Commerry/FERTILIZER_NOx/GUITION ESP32-4848S040/Copilot_20260508_205834.png

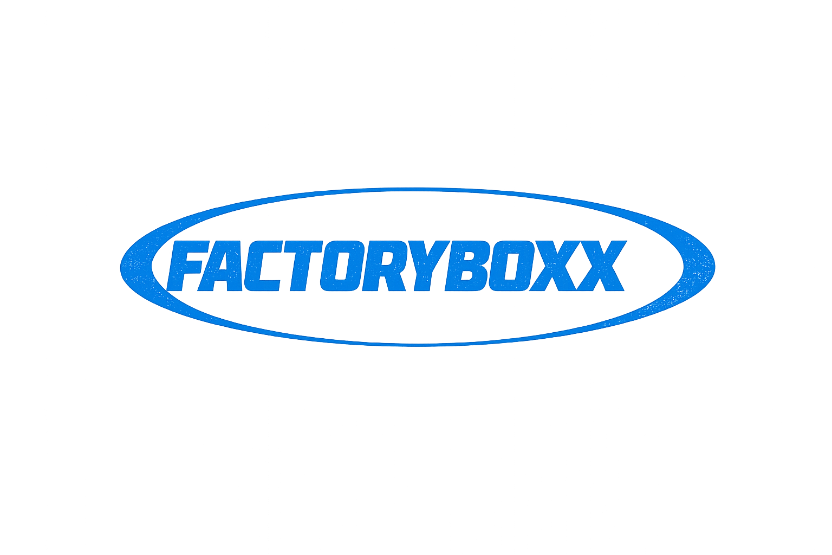
GUITION ESP32-4848S040/Copilot_20260508_205834.png
