Commerry/FERTILIZER_NOx/GUITION ESP32-4848S040/soil.png

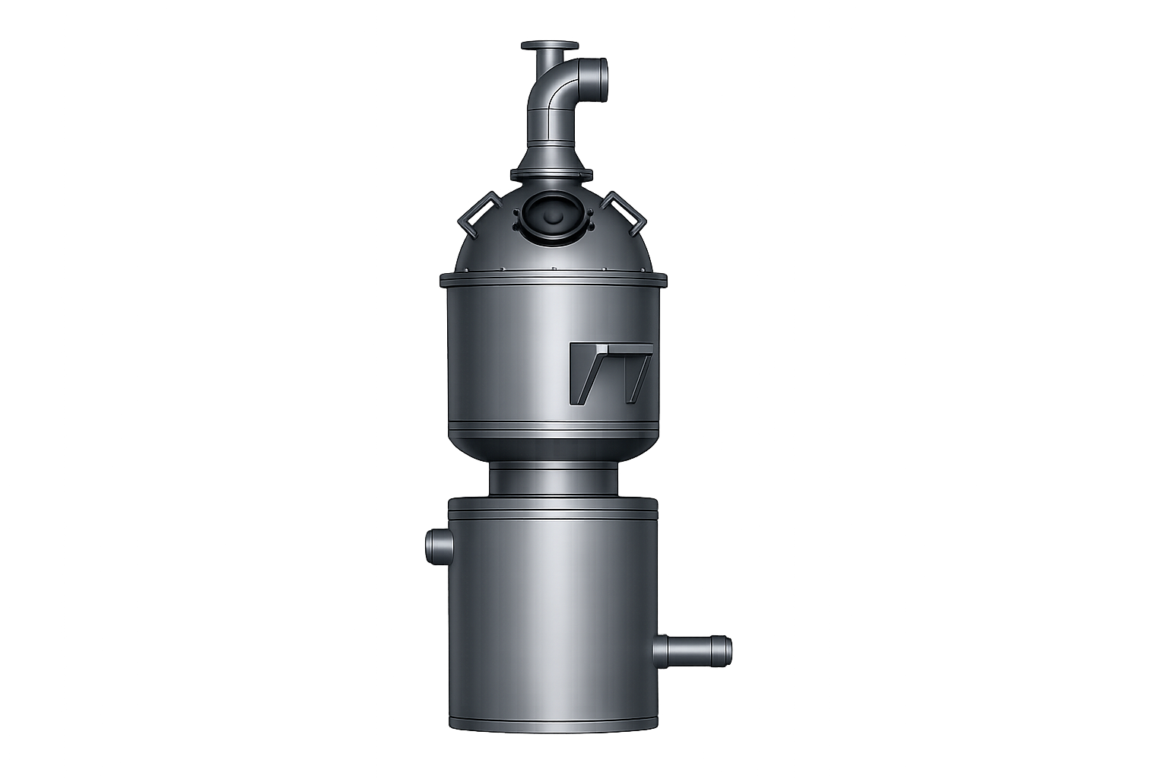
GUITION ESP32-4848S040/soil.png
