Commerry/FERTILIZER_NOx/config.h

// ============================================================================
//  config.h  --  Arduino Nano (ATmega328P)  pin map + ค่าคงที่ของระบบ
//
//  *** แก้ pin / ชื่ออุปกรณ์ ที่ไฟล์นี้ที่เดียว ***
// ============================================================================
#ifndef CONFIG_H
#define CONFIG_H

#include <Arduino.h>

// ===========================================================================
//                            แผนผังขา (ของจริงที่ต่ออยู่)
//
//   D0  RX0   <-- ESP32 GPIO43 (TX)   ลิงก์จอ (HW UART)  ** ถอดจอก่อนอัปโหลด! ข้อ 5 **
//   D1  TX0   --> ESP32 GPIO44 (RX)   ลิงก์จอ            ** ต้องมี divider -- ข้อ 6 **
//   D2        <-- MAX485 RO (2 โมดูลพ่วงกัน)   RS485 (SoftwareSerial RX)
//   D3        --> MAX485 DI (2 โมดูลพ่วงกัน)   RS485 (SoftwareSerial TX)
//   D4        --> Relay วาล์ว RV เปิด (OPEN)
//   D5        --> Relay วาล์ว RV ปิด  (CLOSE)
//   D6        --> MAX485 #2  DE+RE พ่วงกัน   = บัส pressure (id3)  ** ดูข้อ 2 **
//   D7        --> MAX485 #1  DE+RE พ่วงกัน   = บัส O2 (ตามสายที่บัดกรีจริง)
//   D8        --> MAX3485 EN      = บัส O2-B (ดักเฟรม FF)
//   D9        --> CB blower -- ต่อ VSP(สายขาว) ตรง ๆ จ่าย 5V run/stop (ไม่ใช้รีเลย์)
//   D10       --> Relay CP (ปั๊มหมุนเวียน)
//   D11       --> พายลอตแลมป์ เขียว (เดินเครื่อง)
//   D12       --> พายลอตแลมป์ แดง (หยุด/alarm/estop) -- ย้ายจาก D10
//   D13       ว่าง (เดิม Relay FP -- ย้ายไป A5 เพราะ D13 ขับรีเลย์ไม่แรงพอ/LED บูต)
//   A0        <-- ปุ่มรีเซ็ต (กด 5วิ=reset alarm, 10วิ=reset บอร์ด)
//   A1        <-- ปุ่มสำรอง (ยังไม่ใช้)
//   A2        <-- feedback วาล์ว เทา (เปิดสุด)  INPUT_PULLUP
//   A3        <-- feedback วาล์ว ดำ  (ปิดสุด)  INPUT_PULLUP
//   A4        --> Relay FB (โบลเวอร์ป้อน)
//   A5        --> Relay FP (ปั๊มป้อน)
//   A6, A7    *** ใช้เป็น output ไม่ได้เลย *** (ดูข้อ 7)
// ===========================================================================
//
//  เหตุผลที่บังคับ pin map นี้ -- อ่านก่อนย้ายขา!
//
//  1) *** ทำไมจอได้ HW UART (D0/D1) และ RS485 ไป SoftwareSerial (D2/D3) ***
//     ผู้ใช้เลือกเอง (บัดกรี RS485 ตายตัว แต่จอเป็นปลั๊กถอดได้):
//       - ตอนอัปโหลดเฟิร์มแวร์ ต้องถอดสายจอ (D0/D1 ชนกับ USB) -- ถอดง่าย มีปลั๊ก
//       - RS485 บน D2/D3 = ผังเดียวกับที่ทดสอบบนโต๊ะจนพิสูจน์แล้วว่าอ่านได้จริง
//     ข้อแลก: ระหว่าง SoftwareSerial คุย Modbus (ปิด interrupt ~1ms/byte @9600)
//     เฟรมจากจอที่เข้ามาพอดีอาจตกหล่น -> ไม่เป็นไร ลิงก์จอมี CRC + ACK + retry
//     (ออกแบบมาให้ทนหลุดตั้งแต่แรก)  ส่วน Modbus ได้ช่องสัญญาณเงียบ ๆ ของตัวเอง
//
//  2) *** RS485 มี "2 บัสแยกกัน" -- ห้ามยุบรวม! ***
//     pressure transmitter (24V) นิสัยผิดสเปค: หลังตอบครั้งแรกมันขับบัสค้าง
//     (driver hold ~3V) ตลอดเวลา -> ไดรเวอร์ตัวเล็กของ O2 สู้ไม่ได้ = O2 ใบ้สนิท
//     พิสูจน์แล้วด้วยมิเตอร์ + ไล่ทฤษฎีครบ (ขั้ว/กราวด์/bias/id ชน -- ตกหมด)
//     ทางเดียวที่จบ: ขังเดี่ยว pressure ไว้บัสของมันเอง
//       บัส O2 (D6)      : O2#1 id1 + O2#2 id2   (รุ่นเดียวกัน อยู่ร่วมกันได้)
//       บัส pressure (D7): pressure id3 ตัวเดียว
//     RO/DI ใช้สายร่วมกันได้ เพราะเลือกเปิดทีละโมดูล
//
//  3) *** กติกา DE+RE พ่วงขาเดียว/โมดูล (complement rule) ***
//     ขา LOW = โมดูล "เปิดหู" -> RO ขับสาย D2
//     ถ้า D6 กับ D7 LOW พร้อมกัน -> RO สองตัวขับสายเดียวกัน = ชนกัน!
//     กติกาใน modbus_sensors.cpp: ขาที่ไม่ได้ใช้งานต้องค้าง HIGH เสมอ
//     (โมดูลที่ HIGH = หูปิด + ขับบัสตัวเองนิ่งที่ idle = ดีต่อสัญญาณด้วย)
//
//  4) *** D13 (Relay 4 = ปั๊ม FP) มีข้อแลกเปลี่ยนที่ต้องรู้ ***
//     D13 มี LED บนบอร์ดต่ออยู่ และ bootloader กะพริบ LED นี้ทุกครั้งที่รีเซ็ต
//     -> ปั๊ม FP จะกระตุกสั้น ๆ ทุกครั้งที่เปิดเครื่อง / กดรีเซ็ต / อัปโหลดโปรแกรม
//     แก้ในซอฟต์แวร์ไม่ได้ เพราะมันเกิดก่อนโค้ดเราจะได้รัน  (ยอมรับข้อนี้แล้ว)
//
//     สิ่งที่ทำได้แล้ว: ลบไฟ heartbeat ที่เคยกะพริบ D13 ทุก 500 ms ทิ้ง
//     (ถ้าปล่อยไว้ ปั๊มจะคลิกวินาทีละ 2 ครั้ง "ตลอดเวลา" ไม่ใช่แค่ตอนบูต)
//     และ act_begin() ตั้งระดับไฟ "ดับ" ก่อนเปลี่ยนขาเป็น OUTPUT
//     -> ตอนโค้ดเราเริ่มทำงาน ไม่มีคลิกเพิ่มอีก
//
//     ถ้าวันหลังทนไม่ไหว: ย้ายไป D4/D5/D8 (ว่างอยู่) แก้ PIN_RELAY_FP บรรทัดเดียว
//     หรือคา RC low-pass (100k + 10uF) คั่นขา D13 -> รีเลย์ กรองพัลส์สั้นทิ้ง
//     (รอบปั๊มเป็นนาที ๆ อยู่แล้ว หน่วงไม่กี่ร้อย ms ไม่กระทบอะไร)
//
//  5) *** D0/D1 เป็นขาเดียวกับชิพ USB -- ถอดปลั๊กจอก่อนอัปโหลดทุกครั้ง! ***
//     ESP32 ส่งข้อความหา Nano ตลอดเวลา (คำสั่ง + retry) ถ้าเสียบคาไว้ตอนอัปโหลด
//     มันจะพ่นใส่ D0 พร้อมชิพ USB -> "not in sync" อัปไม่ผ่าน
//     จอทำเป็นปลั๊กถอดได้ตามดีไซน์นี้อยู่แล้ว: ถอด -> อัป -> เสียบกลับ
//     และห้ามมี Serial.print() debug ที่ไหนเลย -- Serial คือสายจอแล้ว
//     ขยะจะตกเฟรม/ตก CRC ฝั่งจอ (ลิงก์ไม่พังแต่เปลืองรอบ retry)
//
//  6) *** D1 (TX ของ Nano) เป็น 5V แต่ขา RX ของ ESP32 ทน 3.3V เท่านั้น ***
//     ต้องผ่าน divider 1k/2k ลงเหลือ 3.3V ไม่งั้น ESP32 พัง
//     ส่วนขา D0 (RX ของ Nano) รับ 3.3V จาก ESP32 ได้ตรง ๆ
//     (AVR ที่ 5V ต้องการ VIH = 0.6 x 5 = 3.0V, 3.3V ผ่านเกณฑ์)
//
//  7) *** A6 / A7 ของ Nano สั่งรีเลย์ไม่ได้ *** (คำถามที่ถามมา)
//     A0-A5 = PC0-PC5 เป็น GPIO เต็มตัว: pinMode(A0,OUTPUT) + digitalWrite() ใช้ได้ปกติ
//     แต่ A6/A7 ในแพ็กเกจ TQFP ต่อตรงเข้า ADC อย่างเดียว *ไม่มีวงจรขับขาออกเลย*
//     pinMode(A6,OUTPUT) จะเงียบ ๆ ไม่ทำอะไร -- เป็นกับดักคลาสสิกของ Nano
// ---------------------------------------------------------------------------

// --- ลิงก์ไปจอ (Hardware UART D0/D1) ----------------------------------------
// LINK_SERIAL = Serial (กำหนดใน link_slave.h)  ไม่มีขาให้ตั้ง -- D0/D1 ตายตัว
// baud อยู่ใน link_protocol.h (LINK_BAUD = 38400 -- ต้องตรงกับฝั่ง ESP32)
// *** ถอดปลั๊กจอก่อนอัปโหลดทุกครั้ง (ดูข้อ 5) ***

// --- RS485 / Modbus RTU (SoftwareSerial D2/D3, 2 บัสแยก) --------------------
// *** 3 บัสแยกกัน -- เพราะเซนเซอร์ O2 ทั้งคู่ id ล็อกตายที่ 1 เปลี่ยนไม่ได้ ***
// (reg24 เขียนได้แต่เป็นแค่ช่องเก็บของ ไม่ใช่ address จริง -- พิสูจน์แล้ว)
// อยู่บัสเดียวกัน = ชนกันตลอด -> ขังเดี่ยวตัวละบัส:
//   บัส DE1 (D7, MAX485)  : O2-A  Modbus แท้ id1  -> poll ปกติ (ช่อง O1)
//   บัส DE2 (D6, MAX485)  : pressure id3          -> poll ปกติ
//   บัส DE3 (D8, MAX3485) : O2-B  พ่นเฟรม FF เอง -> ดักฟังเฉย ๆ (ช่อง O2)
#define PIN_RS485_RO        2      // <- TX(RO) ทั้ง 3 โมดูล พ่วงกัน
#define PIN_RS485_DI        3      // -> RX(DI) ทั้ง 3 โมดูล (MAX3485 ผ่าน R 4.7k!)
#define PIN_RS485_DE1       8      // -> EN    = บัส O2-A (Modbus id1) -- MAX3485
#define PIN_RS485_DE2       6      // -> DE+RE = บัส pressure (id3)
#define PIN_RS485_DE3       7      // -> DE+RE = บัส O2-B (ดักเฟรม FF)
// กติกา complement: ขา LOW (เปิดหู) ได้ทีละตัวเท่านั้น -- ห้าม LOW ซ้อน
// idle = DE3 LOW (จอดหูที่บัส O2-B รอเฟรม FF) อีกสองขา HIGH
// ตัว SoftwareSerial ประกาศใน modbus_sensors.cpp

// *** O2-B (ตัวพ่นเอง) ไม่ฟังใคร ***
// เฟรม:  FF 01 07 01 <HI> <LO> 00 00 00 <CS>
//   ค่า O2 = (HI<<8|LO) x 0.1 %   CS = (ผลรวม byte1..8 - 1) & 0xFF
//   1 = O2B มาจากการดักเฟรม FF บนบัส DE3   0 = O2B poll Modbus ปกติ
#define O2B_PASSIVE_FF      1

#define RS485_BAUD_DEFAULT  9600   // แก้ได้ตอน runtime ผ่าน config key CFG_MB_BAUD_IDX
#define RS485_TIMEOUT_MS    300    // รอ slave ตอบนานสุด
#define RS485_POLL_MS       500    // เว้นระยะระหว่างรอบ poll เซนเซอร์

// --- Actuators --------------------------------------------------------------
//
//  อุปกรณ์ที่ Nano คุมมี 4 ตัว (รีเลย์ 4 ตัว) + วาล์ว RV (บอลวาล์ว on/off ใช้ 2 รีเลย์)
//
//  หมายเหตุสำคัญจากสเปก -- 2 อย่างนี้ *ไม่* ต่อเข้า Nano:
//    - N2Gen : "there is a switch ON/OFF separately as option" = มีสวิตช์แยกของมันเอง
//    - CB speed : "adjust speed via HMI or simple VR" -> เลือกใช้ VR ภายนอก
//
#define RELAY_COUNT         4

// *** ขารีเลย์กระบวนการ 4 ตัว (ตามที่ต่อจริง) ***
//   A4/A5 = PC4/PC5 = GPIO เต็มตัว ขับรีเลย์ได้ (ต่างจาก A6/A7)
#define PIN_RELAY_CP       10      // Relay CP -- Circulation Pump (ปั๊มหมุนเวียน) -- ย้ายมา D10
#define PIN_RELAY_CB        9      // CB -- Circulation Blower (BA9080) -- D9 -> VSP(ขาว) ตรง ๆ จ่าย 5V run/stop (ไม่ใช้รีเลย์)
#define PIN_RELAY_FB       A4      // Relay FB -- Feed Blower (โบลเวอร์ป้อน) -- ย้ายมา A4
#define PIN_RELAY_FP       A5      // Relay FP -- Feed Pump (ปั๊มป้อน) -- ย้ายมา A5 (เลี่ยง D13 ที่ขับรีเลย์ไม่แรงพอ)

// *** พายลอตแลมป์ (ไฟสถานะ) -- แยกจากรีเลย์กระบวนการ ***
//   D10/D11 = OC1B/OC2A แต่ใช้เป็น digital output ธรรมดา ไม่ชน PWM วาล์ว (D9=OC1A)
#define PIN_LAMP_RED       12      // ไฟแดง  -- ติดเมื่อหยุด / alarm / E-STOP (ย้ายจาก D10 -> D12 เพราะ CP ยึด D10)
#define PIN_LAMP_GREEN     11      // ไฟเขียว -- ติดเมื่อเดินเครื่อง (RUNNING)

// ลำดับต้องตรงกับ CFG_DEV_* ใน link_protocol.h  (CP=0, CB=1, FB=2, FP=3)
#define ACT_NAME_CP         "CP"
#define ACT_NAME_CB         "CB"
#define ACT_NAME_FB         "FB"
#define ACT_NAME_FP         "FP"
#define ACT_NAME_RV         "RV"

// *** สถานะเริ่มต้น = LOW = ดับ ***  (ตามที่ต้องการ)
//   RELAY_ACTIVE_LOW = 0 -> "ดับ" = ขา LOW / "ติด" = ขา HIGH
//   ตอนบูตขา GPIO เริ่มที่ LOW อยู่แล้ว -> รีเลย์ดับตั้งแต่วินาทีแรก ไม่คลิก
//
//   *** สำคัญ (ความปลอดภัย) ***  ค่านี้ต้องตรงกับชนิดโมดูลรีเลย์ที่ใช้จริง:
//     - โมดูล "high-level trigger" (ติดเมื่อ HIGH)  -> ใช้ 0  <-- ตอนนี้ตั้งไว้แบบนี้
//     - โมดูล "low-level trigger"  (ติดเมื่อ LOW)   -> ต้องเป็น 1
//   ถ้าโมดูลเป็น low-level แต่ตั้ง 0 ไว้ -> พอบูตขา LOW รีเลย์จะ "ติดหมดทุกตัว"!
//   ต่อจริงแล้วถ้าบูตมารีเลย์ติดเอง ให้เปลี่ยนกลับเป็น 1 ทันที
#define RELAY_ACTIVE_LOW    0

// --- Regulation Valve (RV) -- บอลวาล์วไฟฟ้า on/off คุมตำแหน่งด้วยการจับเวลา ---
//
//  วาล์วจริง = FOLS electric ball valve DC24V ชนิด "เปิด/ปิด กลับขั้ว" (แดง/เหลือง)
//  ไม่ใช่ modulating -> ทำ "เปิดครึ่งทาง" ด้วยการจับเวลาขับมอเตอร์ (time-proportioning)
//  มอเตอร์เกียร์ self-lock -> ตัดไฟแล้วค้างตำแหน่ง (ยืนยันจากเทสมือ)
//
//  ต้องใช้ 2 รีเลย์ (H-bridge) เพื่อให้มีสถานะ "หยุด":
//    OPEN  ON เดียว -> แดง=+ เหลือง=-  (หมุนเปิด)
//    CLOSE ON เดียว -> แดง=- เหลือง=+  (หมุนปิด)
//    ทั้งคู่ OFF     -> 2 ขั้วเท่ากัน = ไม่มีแรงดันคร่อม = หยุด (ค้างตำแหน่ง)
//  *** โค้ด valve_drive() กันไม่ให้ขับ OPEN+CLOSE พร้อมกัน ***
#define PIN_VALVE_OPEN      4      // -> Relay เปิด  (D4)
#define PIN_VALVE_CLOSE     5      // -> Relay ปิด   (D5)
#define PIN_VALVE_FB_OPEN   A2     // <- เทา 全开(เปิดสุด)  INPUT_PULLUP, LOW=ถึงแล้ว
#define PIN_VALVE_FB_CLOSED A3     // <- ดำ  关闭(ปิดสุด)  INPUT_PULLUP, LOW=ถึงแล้ว
// *** D9 "ไม่ว่าง" *** -- ตอนนี้ขับ CB blower (สาย VSP 5V run/stop) ดู PIN_RELAY_CB ข้างบน
// สายขาว (COM ของ feedback) ต่อลง GND ร่วม

// เวลาเปิดเต็ม (ปิดสุด -> เปิดสุด) -- วัดจริง 4.30 วิ (เปิด/ปิดเท่ากัน)
#define VALVE_FULL_MS       4300UL
// เขตตาย: ห่างเป้าไม่เกินนี้ -> หยุด (กันมอเตอร์กระตุกไล่เศษ % + ลดสึกหรอ)
#define VALVE_DEADBAND_PCT  4
#define VALVE_MAX_PCT       100

// --- ปุ่มบนตู้ (momentary, ต่อลง GND) ---------------------------------------
// A0/A1 = PC0/PC1 = GPIO เต็มตัว มี internal pullup -> INPUT_PULLUP ได้เลย
// (ไม่เหมือน A6/A7 ที่เป็น analog-input อย่างเดียว ต้อง pullup ภายนอก)
//   กด = LOW
//
// A0 = ปุ่มรีเซ็ต (กดค้างตามเวลา):
//        กดค้าง >= 5 วิ  -> reset alarm (เฉพาะตอนมี alarm ค้างอยู่)
//        กดค้าง >= 10 วิ -> reset บอร์ด Arduino (กรณีบอร์ดค้าง) ผ่าน watchdog
// A1 = ปุ่มสำรอง (ยังไม่ติดตั้ง/ยังไม่ใช้ -- อ่านค่า debounce ไว้เฉย ๆ)
#define PIN_BTN_RESET       A0
#define PIN_BTN_SPARE       A1
#define BTN_DEBOUNCE_MS     40

#define BTN_HOLD_ALARM_MS   5000UL     // กดค้างครบ -> reset alarm
#define BTN_HOLD_BOARD_MS   10000UL    // กดค้างครบ -> reset บอร์ด

// --- อื่น ๆ -----------------------------------------------------------------
// ไม่มี heartbeat LED แล้ว: D13 ที่เคยใช้อยู่ติดกับรีเลย์ 4 ในผังเดิม
// ถ้ายังกะพริบอยู่ รีเลย์จะคลิกวินาทีละ 2 ครั้งตลอดเวลา
// ตัวบอกว่า "Nano ยังไม่ค้าง" คือลิงก์เอง -- จอจะขึ้น OFFLINE เองถ้าเฟรมหยุดมา

// ถ้าไม่ได้รับเฟรมใด ๆ จากจอเกินเวลานี้ -> ยังทำงานต่อได้ (Nano คุมตัวเองได้)
// แต่จะตั้ง flag ให้จอรู้ว่าเคยหลุด
#define LINK_LOSS_MS        3000

// --- EEPROM -----------------------------------------------------------------
#define EEPROM_MAGIC        0x4E33   // 'N2' v3 (band control) -- เปลี่ยนเลขนี้ = ล้าง config ทั้งหมด
#define EEPROM_ADDR_BASE    0

#endif // CONFIG_H
