Commerry/FERTILIZER_NOx/GUITION ESP32-4848S040/Guition_HMI/logo_factoryboxx.c

// ============================================================================
//  logo_factoryboxx.c  --  โลโก้ร้าน FACTORYBOXX (LVGL image, RGB565A8)
//
//  *** สร้างอัตโนมัติจาก Downloads/logo01.png -- อย่าแก้ด้วยมือ ***
//
//  ต้นฉบับเป็นโลโก้ "ขาวบนพื้นดำ" (วงรีเส้นขอบ + ตัวอักษร + texture)
//  วิธีแปลง:
//     alpha = ความสว่างของพิกเซล  (ขาว = ทึบ, ดำ = โปร่ง, ขอบ = ไล่ระดับ)
//     สี    = ฟ้าของแบรนด์คงที่ทุกพิกเซล
//  => ได้โลโก้สีฟ้า พื้นโปร่งใสจริง และเก็บรายละเอียด texture ไว้ครบ
//
//  (อย่าใช้ Copilot_20260508_205834.png -- นั่นเป็นภาพป้าย 3D ทึบเรืองแสง
//   คนละแบบกับโลโก้จริง แปลงยังไงพื้นวงรีทึบก็ติดมาด้วยเสมอ)
//
//  ขนาด 158 x 44  (20856 bytes)
// ============================================================================
#include <lvgl.h>

static const uint8_t logo_factoryboxx_map[] = {
    0x00, 0x00, 0x00, 0x00, 0x00, 0x00, 0x00, 0x00, 0x00, 0x00, 0x00, 0x00, 0x00, 0x00, 0x00, 0x00,
    0x00, 0x00, 0x00, 0x00, 0x00, 0x00, 0x00, 0x00, 0x00, 0x00, 0x00, 0x00, 0x00, 0x00, 0x00, 0x00,
    0x00, 0x00, 0x00, 0x00, 0x00, 0x00, 0x00, 0x00, 0x00, 0x00, 0x00, 0x00, 0x00, 0x00, 0x00, 0x00,
    0x00, 0x00, 0x00, 0x00, 0x00, 0x00, 0x00, 0x00, 0x00, 0x00, 0x00, 0x00, 0x00, 0x00, 0x00, 0x00,
    0x00, 0x00, 0x00, 0x00, 0x00, 0x00, 0x00, 0x00, 0x00, 0x00, 0x00, 0x00, 0x00, 0x00, 0x1F, 0x00,
    0xFF, 0x03, 0x5F, 0x05, 0xFF, 0x3B, 0xFF, 0x03, 0xFF, 0x03, 0x00, 0x00, 0x00, 0x00, 0x00, 0x00,
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
        .cf     = LV_COLOR_FORMAT_RGB565A8,
        .flags  = 0,
        .w      = 158,
        .h      = 44,
        .stride = 316,
        .reserved_2 = 0,
    },
    .data_size = sizeof(logo_factoryboxx_map),
    .data      = logo_factoryboxx_map,
    .reserved  = NULL,
};
