Commerry/FERTILIZER_NOx/GUITION ESP32-4848S040/Guition_HMI/st7701_guition_init.h

// ============================================================================
//  st7701_guition_init.h
//
//  ST7701S init sequence สำหรับ GUITION ESP32-4848S040 โดยเฉพาะ
//
//  ที่มา: คัดลอกมาจาก st7701_type1_init_operations[] ของ Arduino_GFX 1.6.6
//         (display/Arduino_RGB_Display.h บรรทัด 413-523) แล้วแก้ 2 ไบต์
//
//  ทำไมต้อง copy มาแทนที่จะแก้ในไลบรารี:
//     ไลบรารีถูกใช้ร่วมกันทั้งเครื่อง -- แก้ตรงนั้นจะพังโปรเจกต์จออื่นของเรา
//     และหายไปทุกครั้งที่อัปเดต Arduino_GFX
//
//  2 ไบต์ที่แก้ (อ้างอิง Arduino_GFX issue #684 + ESPHome init_sequence):
//     1) 0xCD, 0x08 -> 0x00   ปิด MDT flag  = แก้อาการภาพติดสีแดง
//     2) 0x21 -> 0x20         display inversion OFF = แก้อาการสีกลับด้าน
//
//  ถ้าสียังเพี้ยน ให้สลับ 2 ค่านี้กลับทีละตัวเพื่อไล่หา (บอร์ดล็อตต่างกันมีเพี้ยน)
// ============================================================================
#ifndef ST7701_GUITION_INIT_H
#define ST7701_GUITION_INIT_H

#include <Arduino_GFX_Library.h>

static const uint8_t st7701_guition_init_operations[] = {
    BEGIN_WRITE,
    WRITE_COMMAND_8, 0xFF,
    WRITE_BYTES, 5, 0x77, 0x01, 0x00, 0x00, 0x10,

    WRITE_C8_D16, 0xC0, 0x3B, 0x00,
    WRITE_C8_D16, 0xC1, 0x0D, 0x02,
    WRITE_C8_D16, 0xC2, 0x31, 0x05,
    WRITE_C8_D8, 0xCD, 0x00, // PATCHED: was 0x08 -- MDT flag off (แก้ภาพติดสีแดง)

    WRITE_COMMAND_8, 0xB0, // Positive Voltage Gamma Control
    WRITE_BYTES, 16,
    0x00, 0x11, 0x18, 0x0E,
    0x11, 0x06, 0x07, 0x08,
    0x07, 0x22, 0x04, 0x12,
    0x0F, 0xAA, 0x31, 0x18,

    WRITE_COMMAND_8, 0xB1, // Negative Voltage Gamma Control
    WRITE_BYTES, 16,
    0x00, 0x11, 0x19, 0x0E,
    0x12, 0x07, 0x08, 0x08,
    0x08, 0x22, 0x04, 0x11,
    0x11, 0xA9, 0x32, 0x18,

    // PAGE1
    WRITE_COMMAND_8, 0xFF,
    WRITE_BYTES, 5, 0x77, 0x01, 0x00, 0x00, 0x11,

    WRITE_C8_D8, 0xB0, 0x60, // Vop=4.7375v
    WRITE_C8_D8, 0xB1, 0x32, // VCOM=32
    WRITE_C8_D8, 0xB2, 0x07, // VGH=15v
    WRITE_C8_D8, 0xB3, 0x80,
    WRITE_C8_D8, 0xB5, 0x49, // VGL=-10.17v
    WRITE_C8_D8, 0xB7, 0x85,
    WRITE_C8_D8, 0xB8, 0x21, // AVDD=6.6 & AVCL=-4.6
    WRITE_C8_D8, 0xC1, 0x78,
    WRITE_C8_D8, 0xC2, 0x78,

    WRITE_COMMAND_8, 0xE0,
    WRITE_BYTES, 3, 0x00, 0x1B, 0x02,

    WRITE_COMMAND_8, 0xE1,
    WRITE_BYTES, 11,
    0x08, 0xA0, 0x00, 0x00,
    0x07, 0xA0, 0x00, 0x00,
    0x00, 0x44, 0x44,

    WRITE_COMMAND_8, 0xE2,
    WRITE_BYTES, 12,
    0x11, 0x11, 0x44, 0x44,
    0xED, 0xA0, 0x00, 0x00,
    0xEC, 0xA0, 0x00, 0x00,

    WRITE_COMMAND_8, 0xE3,
    WRITE_BYTES, 4, 0x00, 0x00, 0x11, 0x11,

    WRITE_C8_D16, 0xE4, 0x44, 0x44,

    WRITE_COMMAND_8, 0xE5,
    WRITE_BYTES, 16,
    0x0A, 0xE9, 0xD8, 0xA0,
    0x0C, 0xEB, 0xD8, 0xA0,
    0x0E, 0xED, 0xD8, 0xA0,
    0x10, 0xEF, 0xD8, 0xA0,

    WRITE_COMMAND_8, 0xE6,
    WRITE_BYTES, 4, 0x00, 0x00, 0x11, 0x11,

    WRITE_C8_D16, 0xE7, 0x44, 0x44,

    WRITE_COMMAND_8, 0xE8,
    WRITE_BYTES, 16,
    0x09, 0xE8, 0xD8, 0xA0,
    0x0B, 0xEA, 0xD8, 0xA0,
    0x0D, 0xEC, 0xD8, 0xA0,
    0x0F, 0xEE, 0xD8, 0xA0,

    WRITE_COMMAND_8, 0xEB,
    WRITE_BYTES, 7,
    0x02, 0x00, 0xE4, 0xE4,
    0x88, 0x00, 0x40,

    WRITE_C8_D16, 0xEC, 0x3C, 0x00,

    WRITE_COMMAND_8, 0xED,
    WRITE_BYTES, 16,
    0xAB, 0x89, 0x76, 0x54,
    0x02, 0xFF, 0xFF, 0xFF,
    0xFF, 0xFF, 0xFF, 0x20,
    0x45, 0x67, 0x98, 0xBA,

    //-----------VAP & VAN---------------
    WRITE_COMMAND_8, 0xFF,
    WRITE_BYTES, 5, 0x77, 0x01, 0x00, 0x00, 0x13,

    WRITE_C8_D8, 0xE5, 0xE4,

    WRITE_COMMAND_8, 0xFF,
    WRITE_BYTES, 5, 0x77, 0x01, 0x00, 0x00, 0x00,

    WRITE_COMMAND_8, 0x20,   // PATCHED: was 0x21 -- inversion OFF (แก้สีกลับด้าน)
    WRITE_C8_D8, 0x3A, 0x60, // 0x70 RGB888, 0x60 RGB666, 0x50 RGB565

    WRITE_COMMAND_8, 0x11, // Sleep Out
    END_WRITE,

    DELAY, 120,

    BEGIN_WRITE,
    WRITE_COMMAND_8, 0x29, // Display On
    END_WRITE};

#endif // ST7701_GUITION_INIT_H
