Commerry/FERTILIZER_NOx/GUITION ESP32-4848S040/Guition_HMI/logo_factoryboxx.h

// ============================================================================
//  logo_factoryboxx.h  --  โลโก้ร้าน FACTORYBOXX
//
//  ต้นฉบับ: Downloads/logo01.png  (โลโก้ขาวบนพื้นดำ -- ตัวจริงของแบรนด์)
//  แปลงเป็นสีฟ้า + พื้นโปร่งใส ด้วยสคริปต์ (ดูหัวไฟล์ logo_factoryboxx.c)
// ============================================================================
#ifndef LOGO_FACTORYBOXX_H
#define LOGO_FACTORYBOXX_H

#include <lvgl.h>

// 158 x 44  RGB565A8 (มี alpha -- พื้นโปร่งใสจริง)
extern const lv_image_dsc_t logo_factoryboxx;

#endif // LOGO_FACTORYBOXX_H
