Commerry/FERTILIZER_NOx/GUITION ESP32-4848S040/Guition_HMI/ui_theme.h

// ============================================================================
//  ui_theme.h  --  Dark SCADA theme  (สี / ระยะ / ชื่ออุปกรณ์)
//
//  *** อยากเปลี่ยนหน้าตา แก้ที่ไฟล์นี้ไฟล์เดียว ***
//
//  ธีมเข้มเพราะ:
//    - โลโก้ FACTORYBOXX เป็น neon เรืองแสง -> ต้องพื้นเข้มถึงจะสวย
//    - HMI ในโรงงานอ่านง่ายกว่าในที่แสงน้อย และไม่สะท้อนแสงเข้าตา
//    - สีน้ำเงิน neon ของโลโก้ถูกใช้เป็นสี accent หลักของทั้งระบบ
// ============================================================================
#ifndef UI_THEME_H
#define UI_THEME_H

#include <lvgl.h>

// ---------------------------------------------------------------------------
//  ชื่ออุปกรณ์ -- ต้องตรงกับ ACT_NAME_* ใน config.h ฝั่ง Nano
//  ลำดับต้องตรงกับ CFG_DEV_* : CP=0, CB=1, FB=2, FP=3
// ---------------------------------------------------------------------------
#define UI_NAME_CP        "CP"
#define UI_NAME_CB        "CB"
#define UI_NAME_FB        "FB"
#define UI_NAME_FP        "FP"
#define UI_NAME_RV        "RV"

#define UI_FULL_CP        "CIRCULATION PUMP"
#define UI_FULL_CB        "CIRCULATION BLOWER"
#define UI_FULL_FB        "FEED BLOWER"
#define UI_FULL_FP        "FEED PUMP"
#define UI_FULL_RV        "REGULATION VALVE"

#define UI_MACHINE_NAME   "O2 CONTROL"

// ---------------------------------------------------------------------------
//  หน่วย + ช่วงค่า
// ---------------------------------------------------------------------------
#define UI_UNIT_O2        "%"
#define UI_UNIT_PRESSURE  "bar"

#define UI_O2_MIN         0.0f
#define UI_O2_MAX         25.0f
#define UI_PRESS_MIN      0.0f
#define UI_PRESS_MAX      5.0f

// ---------------------------------------------------------------------------
//  สี -- Light SCADA  (ขาว + เขียวมิ้น)
//
//  ธีมสว่าง: พื้นขาว/มิ้นอ่อน + ตัวอักษรเข้ม + accent เขียวมิ้น
//  *** ตัวอักษรต้องเข้มบนพื้นสว่าง *** (กลับจากธีมมืดเดิมที่ตัวอักษรสว่าง)
//  ปุ่มเลือกสีตัวอักษรเองตามความสว่างของปุ่ม (ดู text_on() ใน ui.cpp)
//  -> ปุ่มสีอ่อนได้ตัวอักษรเข้ม / ปุ่มสีเข้ม-สดได้ตัวอักษรขาว อัตโนมัติ
// ---------------------------------------------------------------------------
#define C_BG            lv_color_hex(0xD3EDE1)   // พื้นหลังรวม (มิ้นอ่อนชัด)
#define C_PANEL         lv_color_hex(0xFFFFFF)   // การ์ด / พาเนล (ขาว -- ลอยเด่นบนพื้นเขียว)
#define C_PANEL_HI      lv_color_hex(0xBBE5D4)   // พาเนลที่เน้น / ถูกเลือก (มิ้นเข้มขึ้น)
#define C_LINE          lv_color_hex(0xAAD0C0)   // เส้นขอบ / เส้นแบ่ง (เขียวมิ้น)
#define C_HEADER        lv_color_hex(0xCBEADD)   // แถบหัว (แถบมิ้น)

// ---------------------------------------------------------------------------
//  ไล่เฉดสี -- "ทุกกรอบ" ในระบบไล่จาก สว่างบน -> เข้มล่าง
//
//  ทำไมต้องทิศเดียวกันทั้งจอ:
//    สมองอ่านไล่เฉดเป็น "แสงมาจากด้านบน" กรอบเลยดูนูนขึ้นมาจริง ๆ
//    ถ้าสลับทิศมั่ว แต่ละกรอบจะดูเหมือนคนละแสง = หลุดกัน ไม่เป็นชิ้นเดียว
//    ทิศนี้ยังตรงกับรูปถัง (soil.png) ที่ไฟส่องจากบนพอดี
//
//  ข้อยกเว้นที่ "ตั้งใจ" กลับหัว (เข้มบน-สว่างล่าง) = ดูจมลงไป:
//    - ตอนกดปุ่ม   -> feedback ว่ากดโดนจริง
//    - ราง bar / slider / ช่องพิมพ์ / กล่อง log -> เป็นร่อง ไม่ใช่ของนูน
//
//  ค่าเฉลี่ยของแต่ละคู่ตั้งให้ใกล้สีเดิม -> โทนรวมไม่เปลี่ยน แค่มีมิติขึ้น
// ---------------------------------------------------------------------------
// พื้นจอ: ไล่เฉดชัด อ่อนด้านบน -> มิ้นเข้มด้านล่าง (แบบท้องฟ้า) ให้ดูมีมิติ
// ช่วงกว้างขึ้นกว่าเดิม -> เห็นเป็นไล่เฉดจริง ไม่ใช่แค่โทนเดียว
#define C_BG_TOP        lv_color_hex(0xEBF8F2)   // เกือบขาว (ยอดจอ)
#define C_BG_BOT        lv_color_hex(0xA2D9C5)   // มิ้นเข้ม (ก้นจอ)

#define C_PANEL_TOP     lv_color_hex(0xFFFFFF)   // การ์ดทั่วไป (ขาว -- เด่นบนพื้นเขียว)
#define C_PANEL_BOT     lv_color_hex(0xE9F5EF)

#define C_PANEL_HI_TOP  lv_color_hex(0xD0EEE1)   // การ์ด/แถวที่ถูกเน้นหรือถูกกด (มิ้นเข้ม)
#define C_PANEL_HI_BOT  lv_color_hex(0xAEDECB)

#define C_HEADER_TOP    lv_color_hex(0xD8F1E7)   // แถบหัว + แถบนำทาง (แถบมิ้น)
#define C_HEADER_BOT    lv_color_hex(0xBEE5D6)

// ร่อง (ราง bar/slider, ช่องพิมพ์): บนเข้ม-ล่างสว่าง = ดูจมลงไปบนพื้นสว่าง
#define C_SUNK_TOP      lv_color_hex(0xBAD8CC)
#define C_SUNK_BOT      lv_color_hex(0xE4F3EC)

#define C_LOG_TOP       lv_color_hex(0xD4E9E0)   // กล่อง log (console จม ๆ บนพื้นเขียว)
#define C_LOG_BOT       lv_color_hex(0xE9F5EF)

// ปุ่มสี: จากสีฐาน ให้สว่างขึ้นที่ขอบบน / เข้มลงที่ขอบล่าง (0-255)
// ธีมสว่าง -> ลดลงจากเดิมนิดหน่อย ไม่ให้ปุ่มสีอ่อนสว่างจนขอบหาย
#define UI_GRAD_UP       28
#define UI_GRAD_DN       48

#define C_TEXT          lv_color_hex(0x18241F)   // ตัวหนังสือหลัก (เกือบดำ อมเขียว)
#define C_TEXT_DIM      lv_color_hex(0x54685F)   // คำอธิบาย / หน่วย (เทาเข้ม)
#define C_TEXT_MUTE     lv_color_hex(0x7C9389)   // จาง ๆ / ถูกล็อก (เข้มขึ้นให้ชัดบนพื้นมิ้น)

// สี accent -- เขียวมิ้น (สีหลักของธีมใหม่)
#define C_NEON          lv_color_hex(0x0FB89A)   // เขียวมิ้นเข้ม -- อ่านออกบนพื้นขาว
#define C_NEON_DIM      lv_color_hex(0x9AD7CC)   // มิ้นจาง (ท่อ/ของที่ยังไม่ทำงาน)

// สีโลโก้ FACTORYBOXX -- คงสีฟ้าแบรนด์ไว้ (รูปจริง ฟ้าบนขาวอ่านออกดี)
#define C_LOGO          lv_color_hex(0x1E88E5)

#define C_OK            lv_color_hex(0x15A34A)   // เขียวหญ้าเข้ม = ทำงาน/ปกติ (ต่างจากมิ้น accent)
#define C_WARN          lv_color_hex(0xD97706)   // ส้มอำพันเข้ม = เตือน
#define C_ALARM         lv_color_hex(0xDC2626)   // แดงเข้ม = ผิดปกติ / E-STOP
#define C_OFF           lv_color_hex(0xB4C2BC)   // เทาอ่อน = ดับอยู่

// สีประจำเซนเซอร์ (เข้มพออ่านออกบนขาว)
#define C_O2A           lv_color_hex(0x0891B2)   // O2 #1 (ตัวหลัก) -- ฟ้าเทอร์คอยซ์
#define C_O2B           lv_color_hex(0x7C3AED)   // O2 #2 (ตัวรีเช็ค) -- ม่วงเข้ม
#define C_PRESS         lv_color_hex(0xD97706)   // Pressure -- ส้ม

// ---------------------------------------------------------------------------
//  สีประจำ "ชนิดของไหล" ในผัง P&ID หน้าหลัก
//
//  แยกสีตามสิ่งที่ไหลอยู่ในท่อ ไม่ใช่ตามอุปกรณ์ -- เป็นวิธีของ SCADA จริง
//  มองแวบเดียวรู้เลยว่าเส้นไหนคือของเหลว เส้นไหนคือแก๊ส เส้นไหนคือ N2
//  (ท่อที่ไม่มีของไหล = สีเส้นขอบธรรมดา C_LINE)
// ---------------------------------------------------------------------------
// เข้มพอให้ท่อเด่นบนพื้นขาว (สีอ่อนจะจมหายไปกับพื้น)
#define C_MED_LIQ       lv_color_hex(0x2563EB)   // ของเหลว (CP, FP, ปุ๋ยออก) -- น้ำเงิน
#define C_MED_GAS       lv_color_hex(0x0D9488)   // แก๊ส    (vent, CB, FB, mixer) -- เขียวเทอร์คอยซ์
#define C_MED_N2        lv_color_hex(0x7C3AED)   // ไนโตรเจน (N2Gen -> RV -> mixer) -- ม่วง

// สีประจำโซนควบคุมวาล์ว RV -- ไล่จาก "เร่ง/หยาบ" ไป "นิ่ง/ละเอียด" (เข้มพออ่านบนขาว)
#define C_ZONE_MAXOUT   lv_color_hex(0xDC2626)   // แดง   -- เปิดสุด ไล่อากาศ
#define C_ZONE_ROUGH    lv_color_hex(0xEA580C)   // ส้ม   -- ก้าวใหญ่
#define C_ZONE_MEDIUM   lv_color_hex(0xD97706)   // อำพัน -- ก้าวเล็ก
#define C_ZONE_FINE     lv_color_hex(0x15A34A)   // เขียว  -- PID คุมนิ่งแล้ว
#define C_ZONE_OFF      lv_color_hex(0xB4C2BC)   // เทาอ่อน -- ไม่ได้คุม

// ---------------------------------------------------------------------------
//  ระยะ (จอ 480 x 480)
//
//    header   58 px   โลโก้ (190x53) + ชื่อหน้า + สถานะลิงก์
//    content 366 px
//    nav bar  56 px   ปุ่มสลับหน้า 5 ปุ่ม
//
//  *** ทุกหน้าต้องวางของให้อยู่ในกรอบ UI_BODY_H เท่านั้น ***
//  เผลอวางเกินแล้วจะไปโผล่ทับ nav bar โดยที่คอมไพเลอร์ไม่เตือนอะไรเลย
// ---------------------------------------------------------------------------
#define UI_W            480
#define UI_H            480

#define UI_HEADER_H      58
#define UI_NAV_H         56
#define UI_BODY_H       (UI_H - UI_HEADER_H - UI_NAV_H)     // 366

#define UI_PAD            8
#define UI_RADIUS        10

#endif // UI_THEME_H
