Commerry/FERTILIZER_NOx/(commit log)

2026-11-01 FERTILIZER NOx O2-control firmware (Nano + ESP32 HMI)
    Nano: band valve control (timed-position H-bridge), paced $K config dump,
    4s watchdog, O2-B stale-at-boot fix, band hysteresis.
    Display: RX buffer fix (setRxBufferSize before begin), capped $G retry,
    offline PIN fallback gated on link-ever-up, global auto-logout, command resync.
    Includes setup.ps1 / flash.ps1 for one-command install + flash, and docs.
    [Arduinonano_Display_O2_pressure.ino, BusMap.ino, BusProbe.ino, BusReadAll.ino, D8Probe.ino, FindO2.ino, Guition_HMI.ino, LineDoctor.ino]
2026-11-05 Display SETUP cleanup for customer: remove dead PID group, relabel band fields
    RV is band control (not PID/step). Removed PID group (Kp/Ki/Kd/O2 target) and
    STEP INTERVAL from SETUP. Relabeled ROUGH/MEDIUM "STEP" -> "VALVE %",
    VALVE MIN/MAX OUTPUT -> FINE/MAXOUT "VALVE %"; show the 3 O2 band edges clearly.
2026-11-05 Flash: set ESP32 UploadSpeed=115200 (921600 fails on CH340/Mac)
2026-11-05 HMI: restore default PIN fallback when config has not synced
    The linkEverUp gate rejected the default PINs once the link had been up
    but no $K values had arrived, so operators could not log in at all when
    display-to-Nano traffic was failing. Compare against the Nano value when
    held and the display default otherwise, and remove the unused field.
    [app_state.h, ui.cpp, ui_setup.cpp]
2026-11-09 Windows setup: fix scripts that could not run on a fresh PC
    - Save setup.ps1/flash.ps1 as UTF-8 with BOM. Windows PowerShell 5.1
    reads BOM-less files as ANSI, so the Thai text broke parsing
    (5 and 7 parse errors) and neither script could run at all.
    - setup.ps1: pin directories.user to %USERPROFILE%\Documents\Arduino so
    lvgl and lv_conf.h land in the same folder even when Documents is
    redirected to OneDrive; stop on any arduino-cli failure instead of
    printing done; force TLS 1.2 and hide the slow progress bar.
    - Name the helper Invoke-Acli (a function named Cli is shadowed by the
    built-in cli alias for Clear-Item).
    - INSTALL.md: winget Git install, board list, and flash commands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
2026-11-09 setup.ps1: fetch esp32 archives from the Espressif mirror
    GitHub release downloads were failing with 504 Gateway Timeout for more
    than half of the esp32 3.3.11 archives, so setup stopped on a customer
    PC. Changing the package index did not help because arduino-cli takes
    the esp32 URLs from Arduino's own package_index.json.
    Download the same archives (core + tools, ~1.8 GB) from
    dl.espressif.com/github_assets into the arduino-cli staging folder
    first; arduino-cli then finds them, checks SHA-256 and skips GitHub.
    Already-downloaded files of the right size are skipped on re-run.
    The data and downloads folders are now set explicitly.
    Tested in an isolated arduino-cli 1.5.2-rc.1 setup: all arch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
2026-11-09 flash: fix Nano build from a clone named FERTILIZER_NOx
    arduino-cli requires the sketch folder to match the main .ino name, so
    "flash nano" failed with "main file missing from sketch" in any clone
    of the repo (the folder is FERTILIZER_NOx, the sketch is
    Arduinonano_Display_O2_pressure.ino). Copy the Nano sources into
    tools-bin/nano-sketch/Arduinonano_Display_O2_pressure and build there.
    If the upload fails with the new-bootloader FQBN, retry automatically
    with cpu=atmega328old (common on clone Nanos).
    Tested on Windows from a fresh clone named FERTILIZER_NOx: the Nano
    build succeeds (20660 bytes) and the old-bootloader retry runs.
